valerium-labs/zx-unikeyboard/Photos/on_speccy.jpg

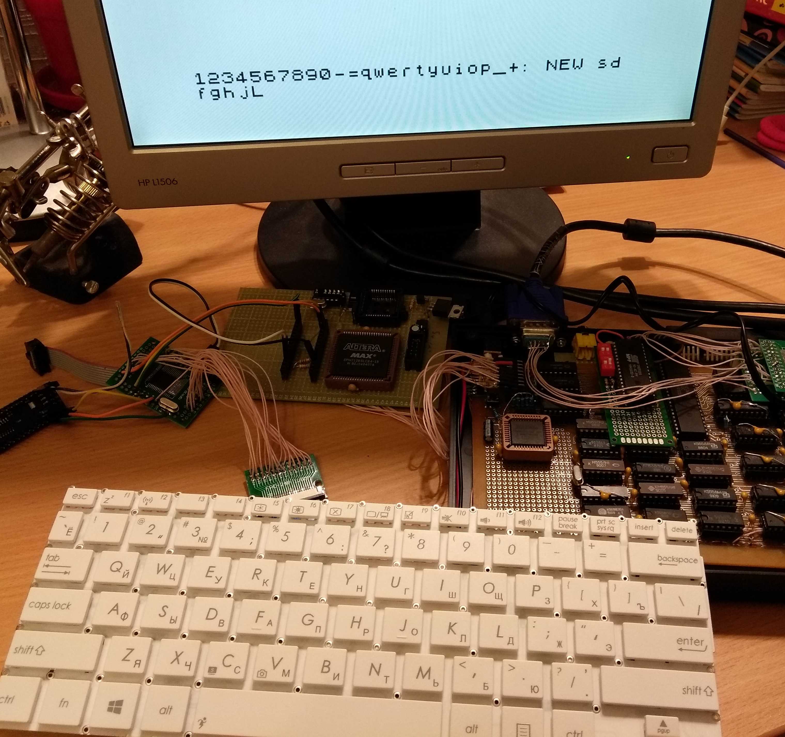
Photos/on_speccy.jpg
