valerium-labs/zx-unikeyboard/Photos/devboard.jpg

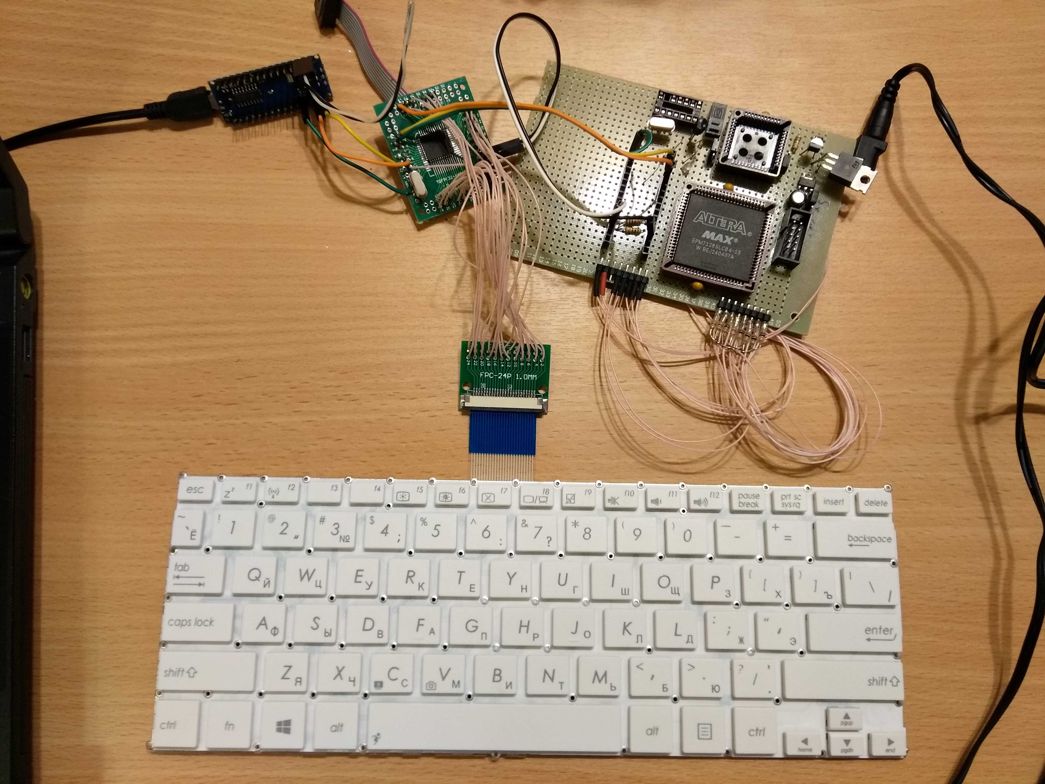
Photos/devboard.jpg
