valerium-labs/zx-unikeyboard/avr_keyexplorer/readme.txt

This is and AVR firmware source code for "Unikeyboard explorer" (keyboard matrix scanning software).
Scans any keyboard and generates the debug output on UART for col/row of key pressed.

Atmega32-16AU, 8Mhz internal clock

Designed for custom keyboard matrix by Valeriy Matveyev
valerium@rambler.ru
Russia, 2021
