valerium-labs/zx-unikeyboard/avr_keyexplorer/AsusX200_keymatrix.PNG

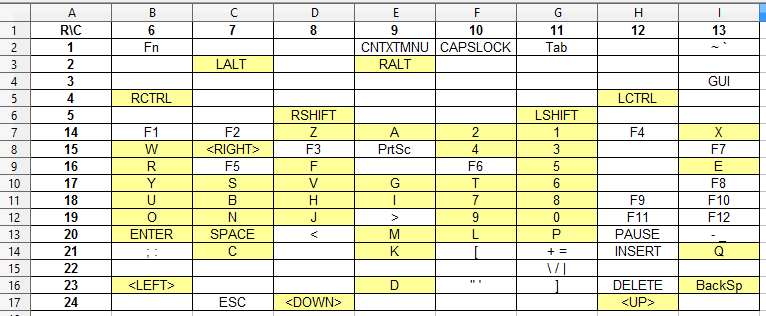
avr_keyexplorer/AsusX200_keymatrix.PNG
