valerium-labs/zx-unikeyboard/Photos/AsusX200Keyb.jpg

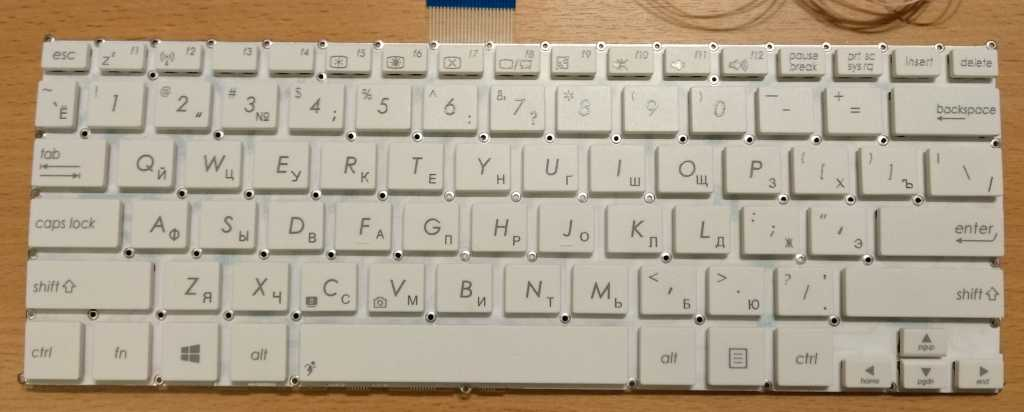
Photos/AsusX200Keyb.jpg
