valerium-labs/zx-unikeyboard/Photos/AsusX551keyb.jpg

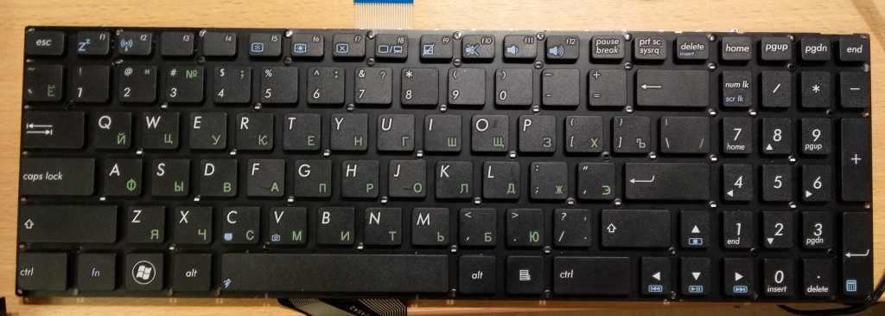
Photos/AsusX551keyb.jpg
