valerium-labs/zx-unikeyboard/Photos/keyb1_1.jpg

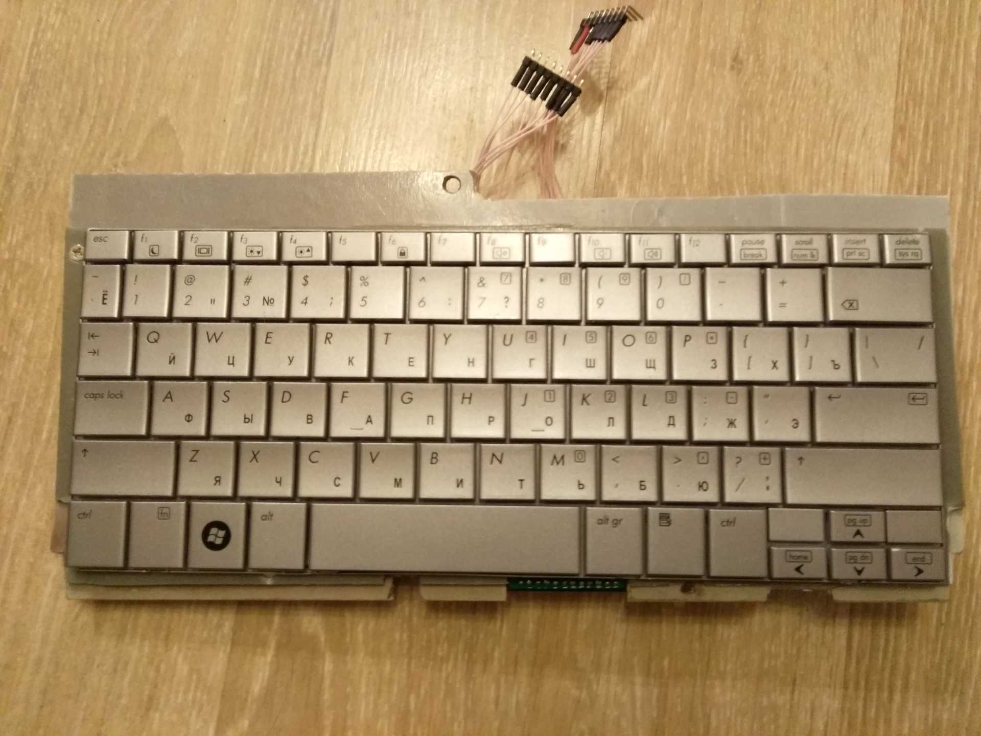
Photos/keyb1_1.jpg
