valerium-labs/zx-unikeyboard/Photos/keyb1_2.jpg

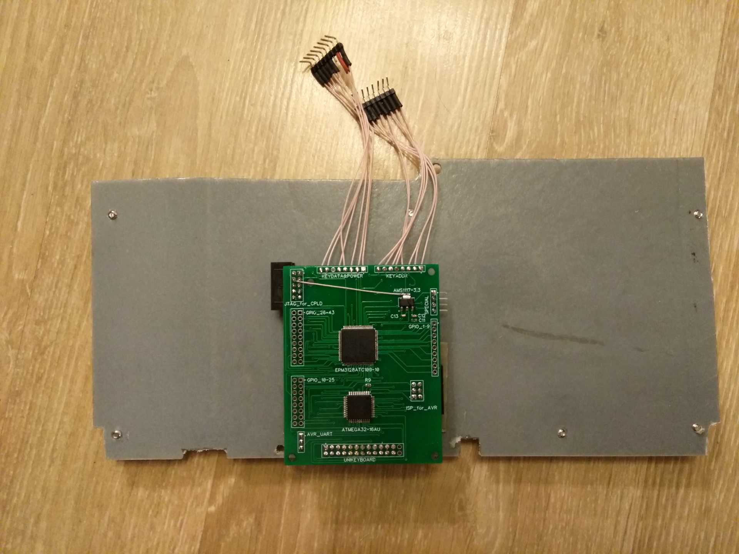
Photos/keyb1_2.jpg
