valerium-labs/zx-unikeyboard/Photos/keyb1_3.jpg

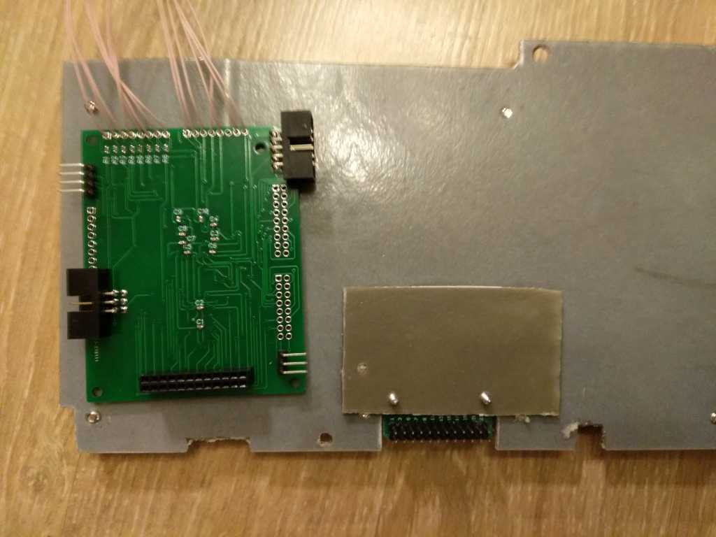
Photos/keyb1_3.jpg
