valerium-labs/zx-unikeyboard/Photos/keyb2_1.jpg

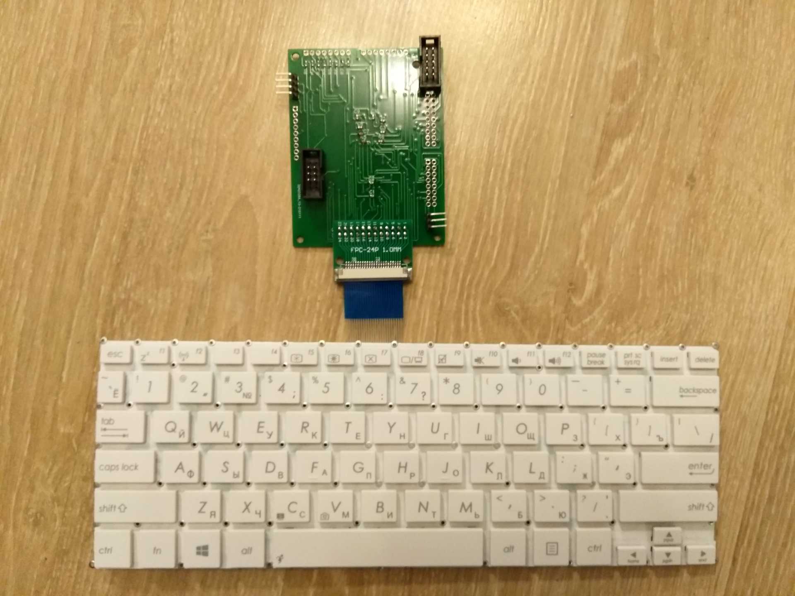
Photos/keyb2_1.jpg
