valerium-labs/zx-unikeyboard/Photos/keyb2_2.jpg

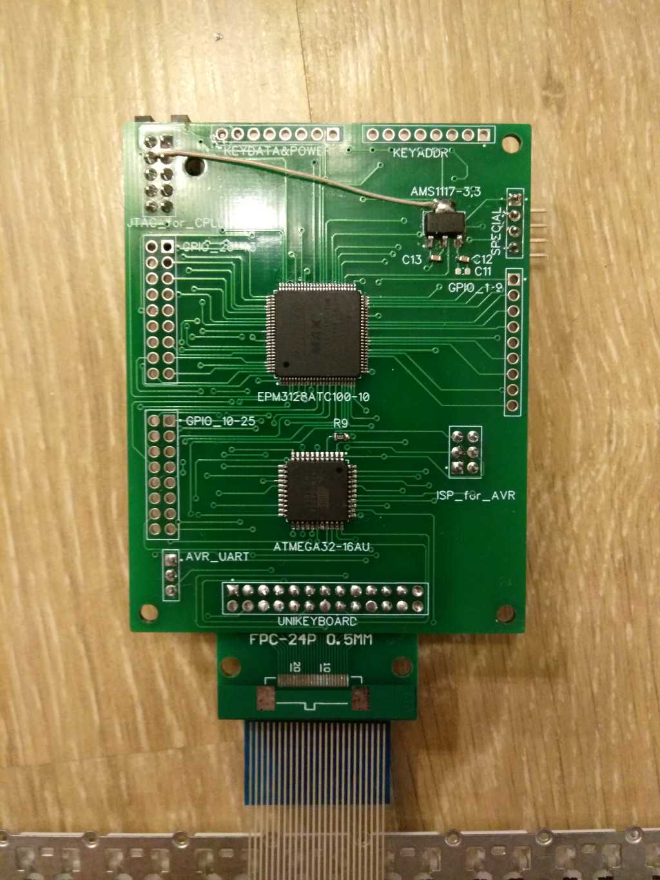
Photos/keyb2_2.jpg
