valerium-labs/zx-unikeyboard/Photos/ZXUK_AnalyzeRq.PNG

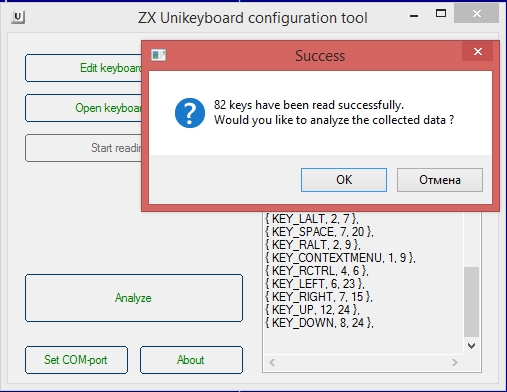
Photos/ZXUK_AnalyzeRq.PNG
