valerium-labs/zx-unikeyboard/Photos/ZXUK_reading.PNG

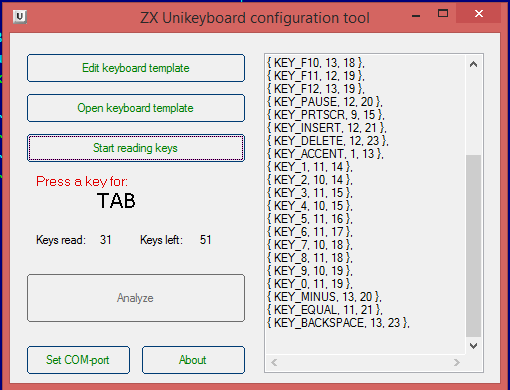
Photos/ZXUK_reading.PNG
