valerium-labs/zx-unikeyboard/Schematic/sch_atmega32_epm3128_devboard.pdf

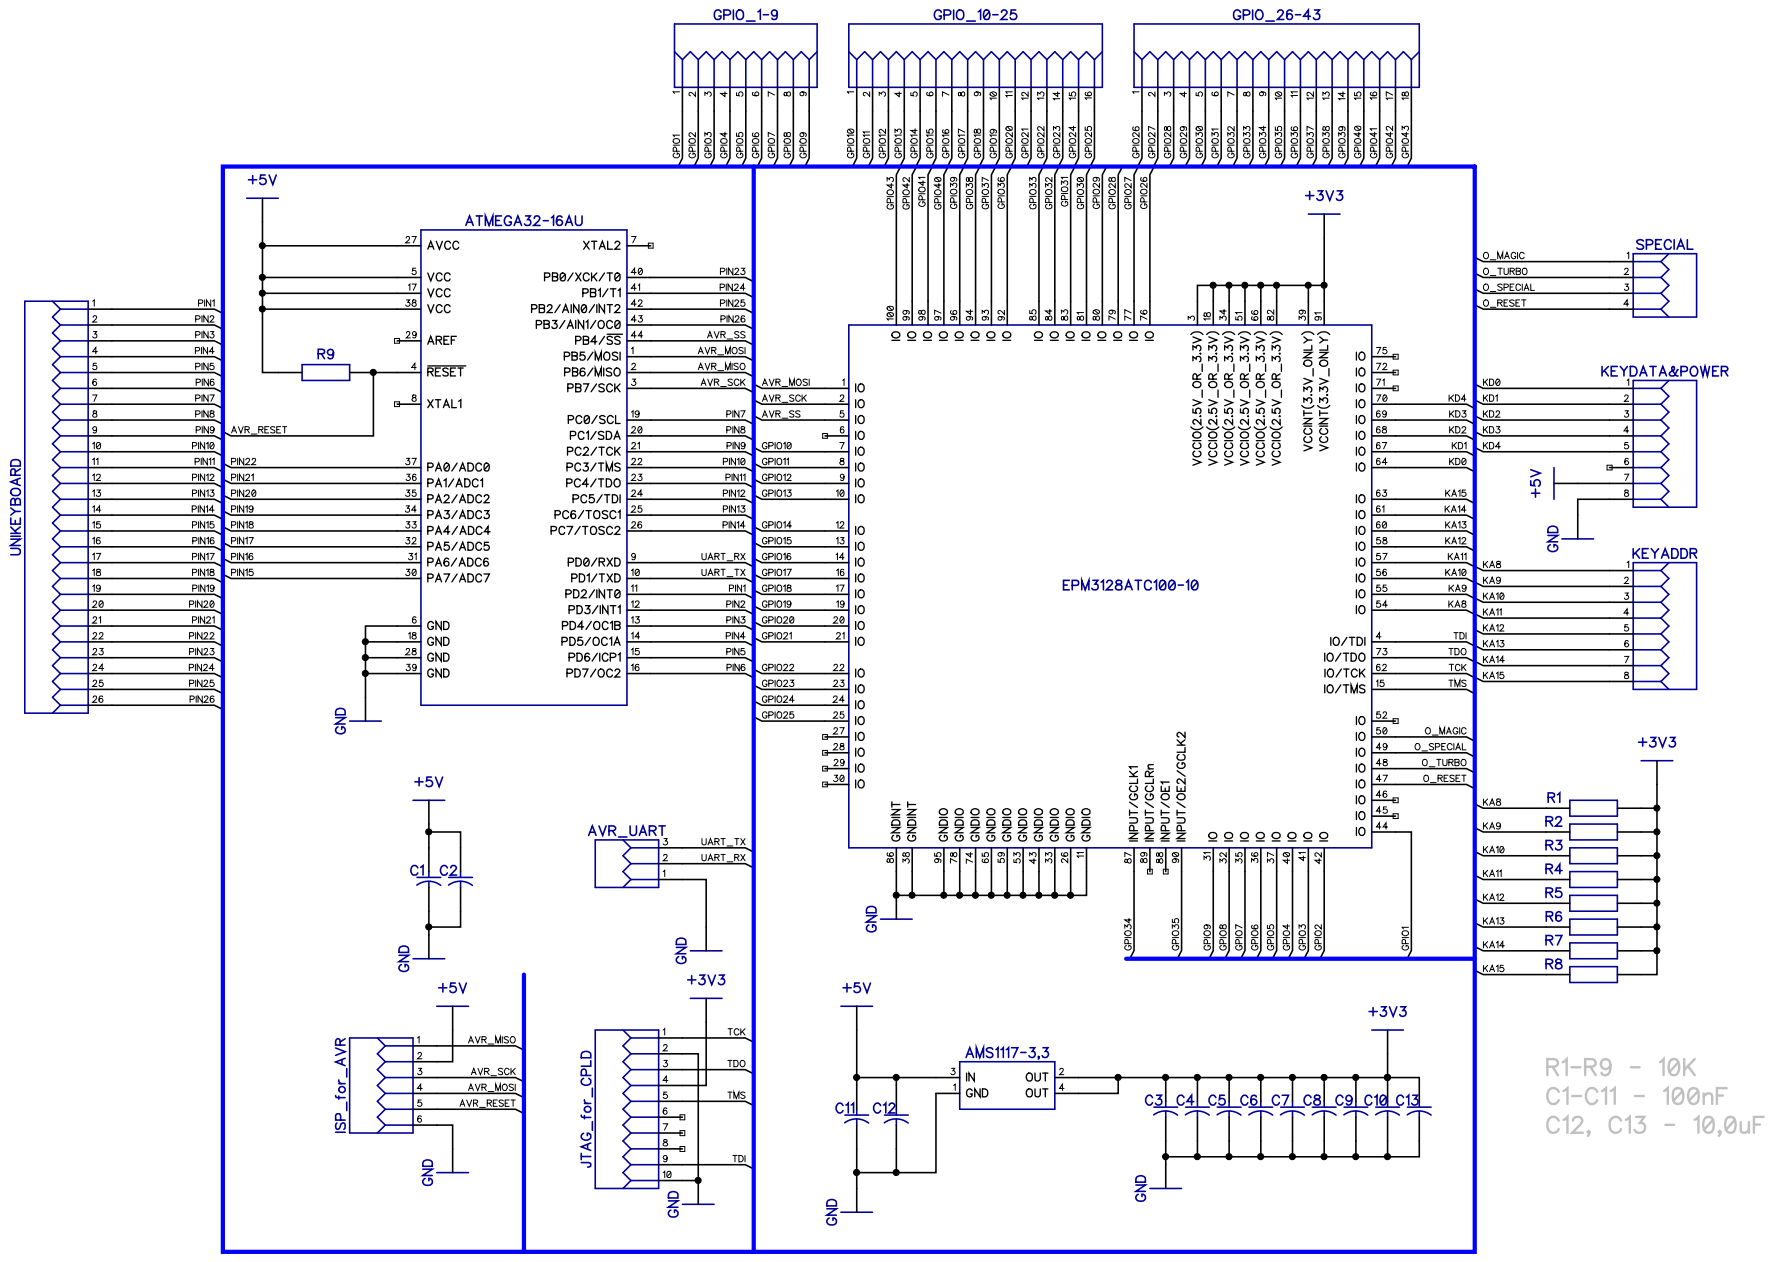
[picture p13: page 1]
