valerium-labs/zx-unikeyboard/Schematic/sch_atmega32_epm7128.pdf

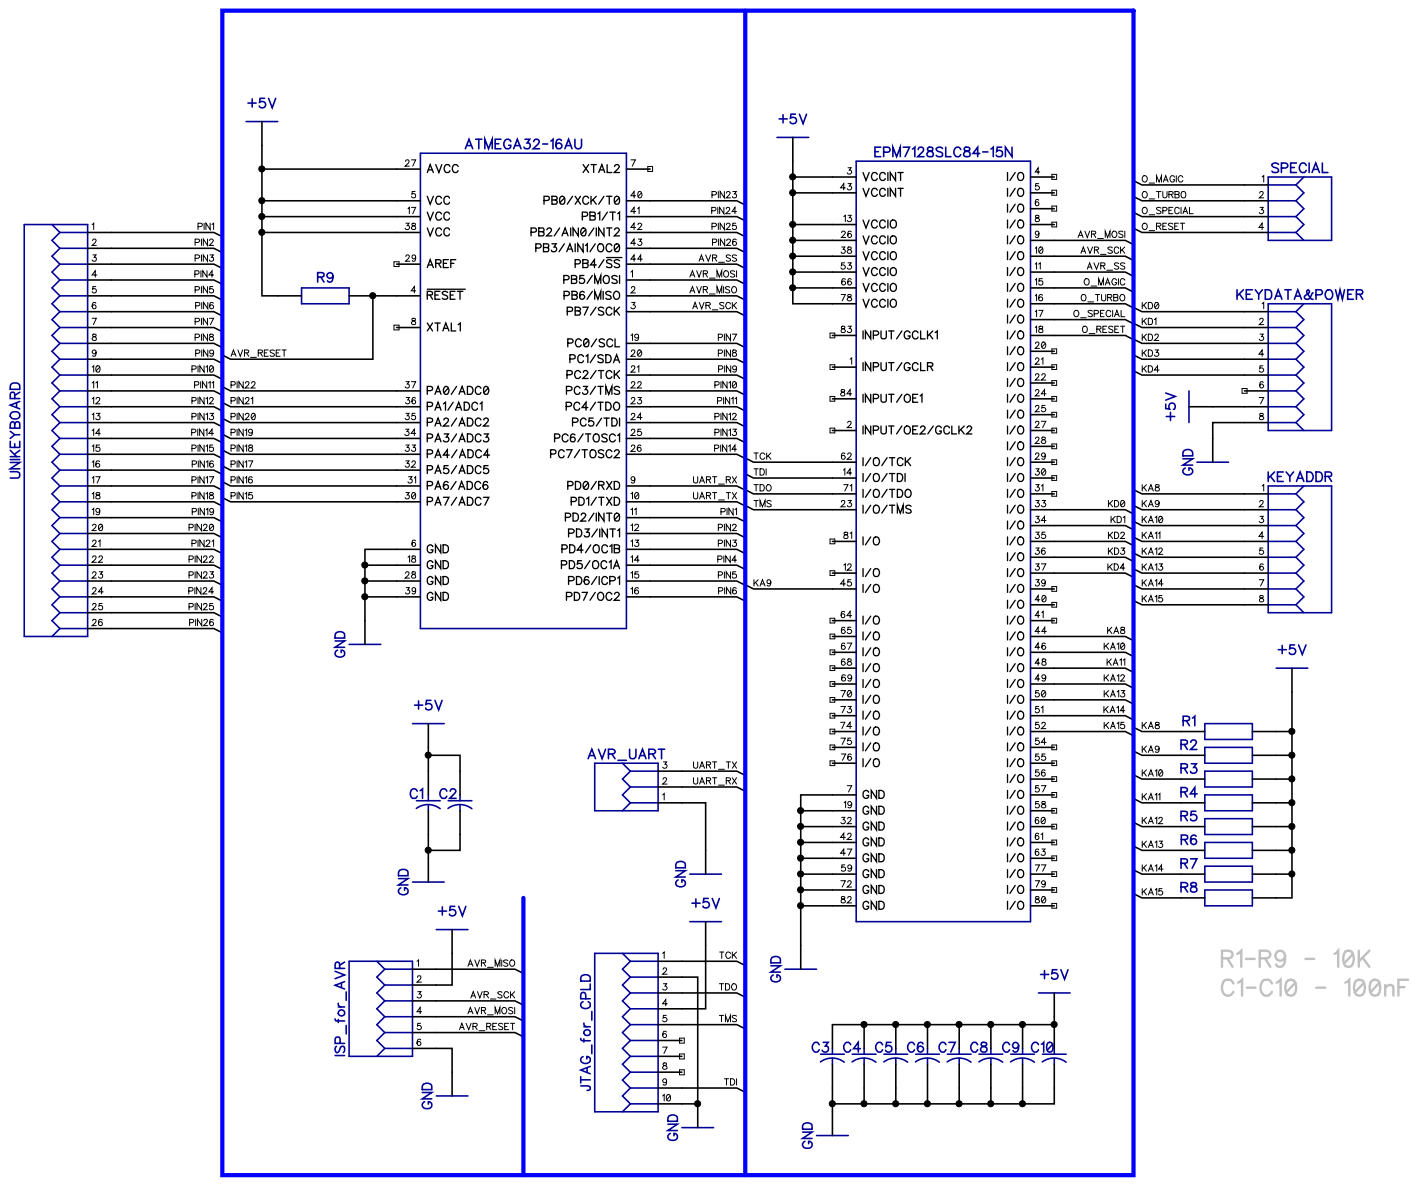
[picture p14: page 1]
